zidooong/wood-bridge-3d/files/bridge-v2-hook-model.step

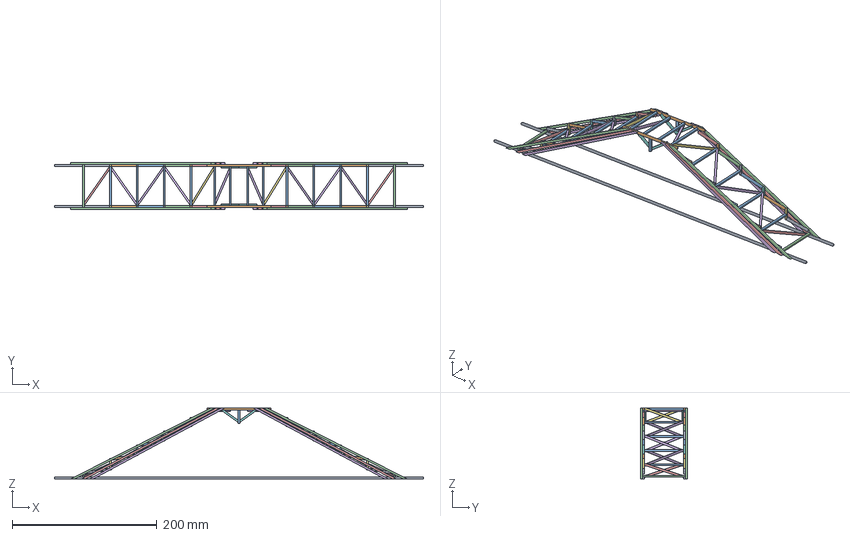
[picture p8: CAD file, 2026-10-19]
files/bridge-v2-hook-model.step
510.0 x 64.5 x 98.0 mm
