zidooong/wood-bridge-3d/files/bridge-lattice-90mm-model.step

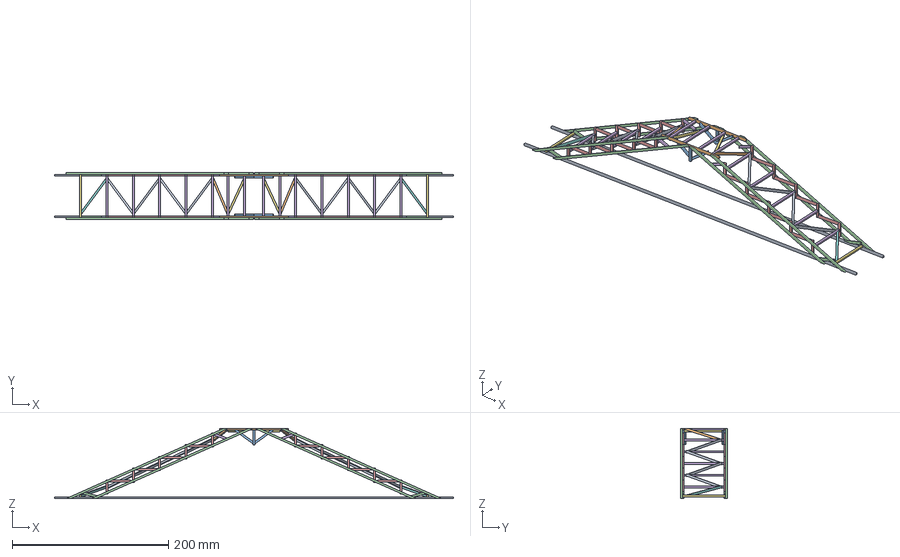
[picture p9: CAD file, 2026-10-19]
files/bridge-lattice-90mm-model.step
510.0 x 60.5 x 90.0 mm
