zidooong/wood-bridge-3d/files/bridge-lattice-model.step

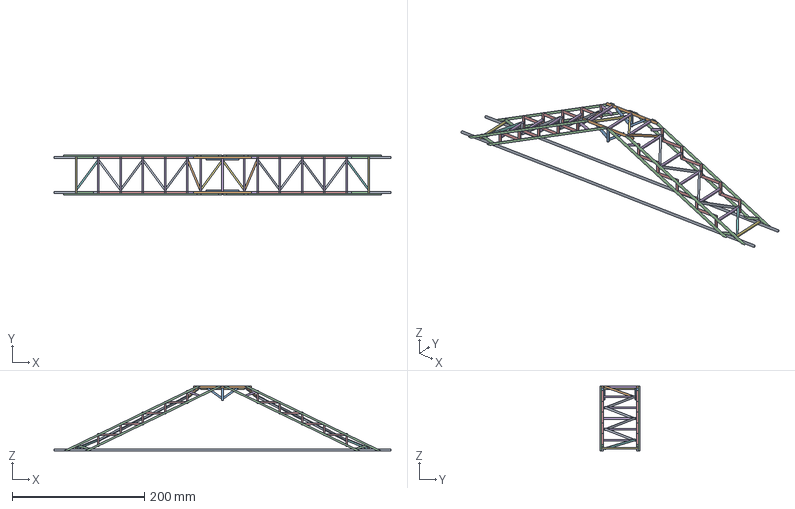
[picture p10: CAD file, 2026-10-18]
files/bridge-lattice-model.step
510.0 x 60.5 x 98.0 mm
