zidooong/wood-bridge-3d/files/bridge-v2-model.step

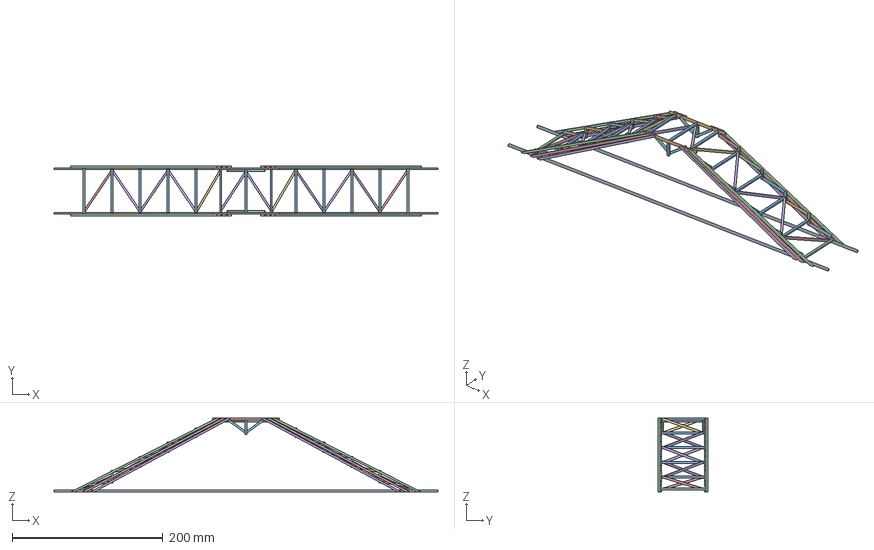
[picture p11: CAD file, 2026-10-18]
files/bridge-v2-model.step
510.0 x 66.5 x 98.0 mm
