zidooong/wood-bridge-3d/files/bridge-v1-hook-model.step

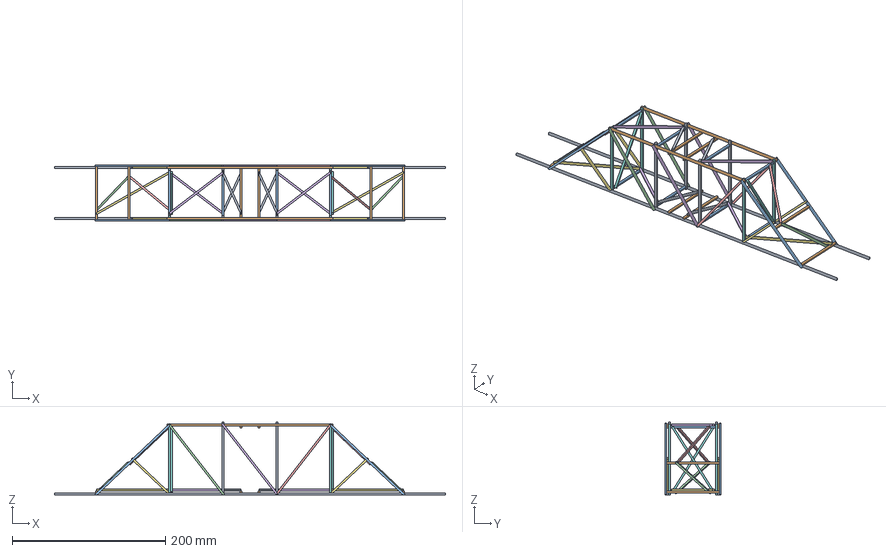
[picture p12: CAD file, 2026-10-19, an earlier design]
files/bridge-v1-hook-model.step
510.0 x 73.5 x 95.0 mm
