zidooong/wood-bridge-3d/files/bridge-model.step

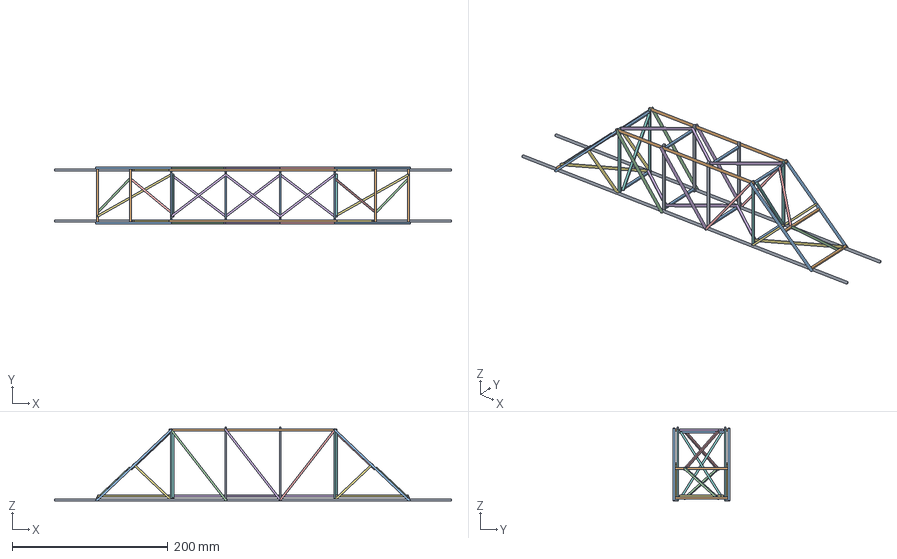
[picture p13: CAD file, 2026-10-18, an earlier design]
files/bridge-model.step
510.0 x 73.5 x 95.0 mm
