zidooong/wood-bridge-3d/(commit log)

2026-10-18 Publish wood bridge 3D viewer and E2 construction drawings
    [bridge-model.step]
2026-10-18 Add optimized bridge plan with audited solids and conditional load analysis
    [bridge-v2-model.step]
2026-10-18 Add compliant double-rail lattice as second bridge plan
    [bridge-lattice-model.step]
2026-10-19 Clear central hook path, lower lattice bridge to 90mm, and show build dimensions
    [bridge-lattice-90mm-model.step]
2026-10-19 Add full-height central hook clearance to plans two and three
    [bridge-v1-hook-model.step, bridge-v2-hook-model.step]
